hexagon5un/everled/docs/DSCF9905.JPG

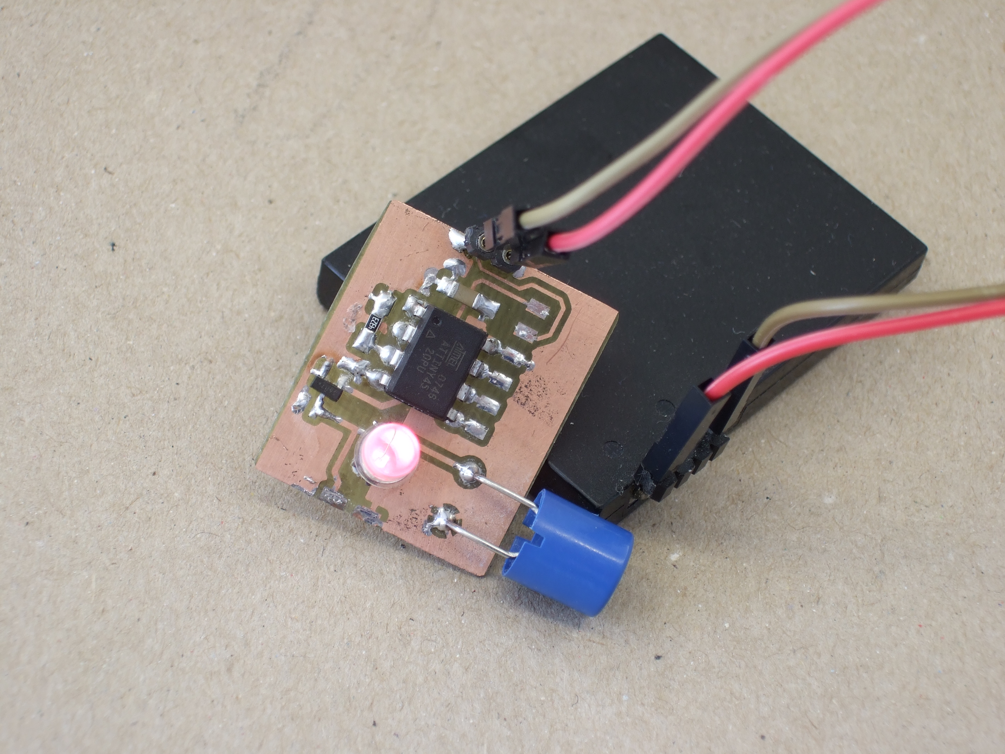
docs/DSCF9905.JPG
