hexagon5un/everled/docs/everled-F.Cu.pdf

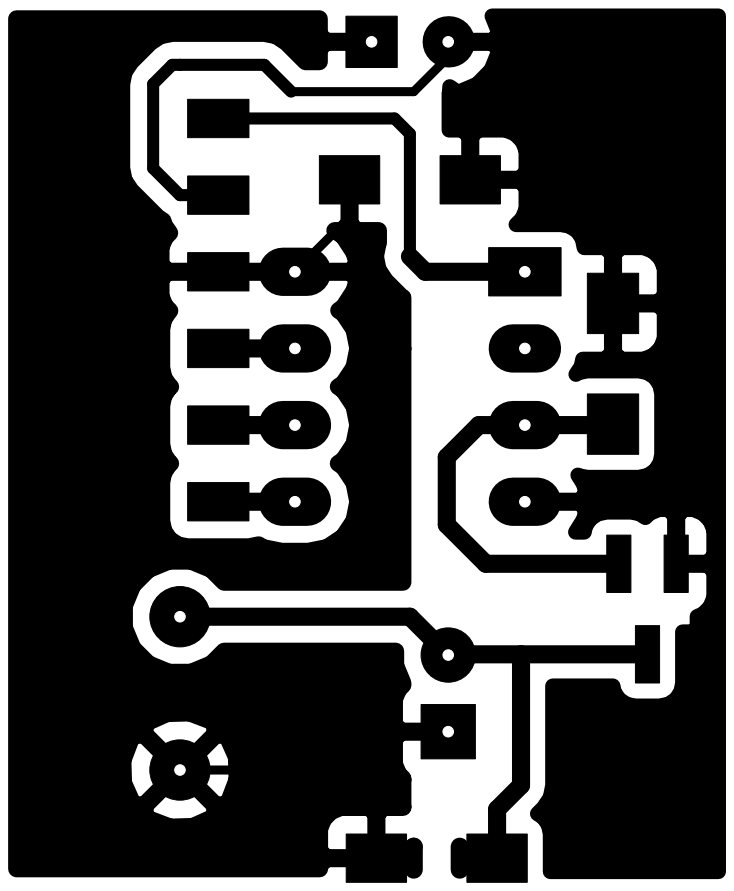
[picture p4: page 1]
