hexagon5un/everled/hardware/everled.kicad_pcb

## KiCad design hardware/everled.kicad_pcb (2017-06-26)

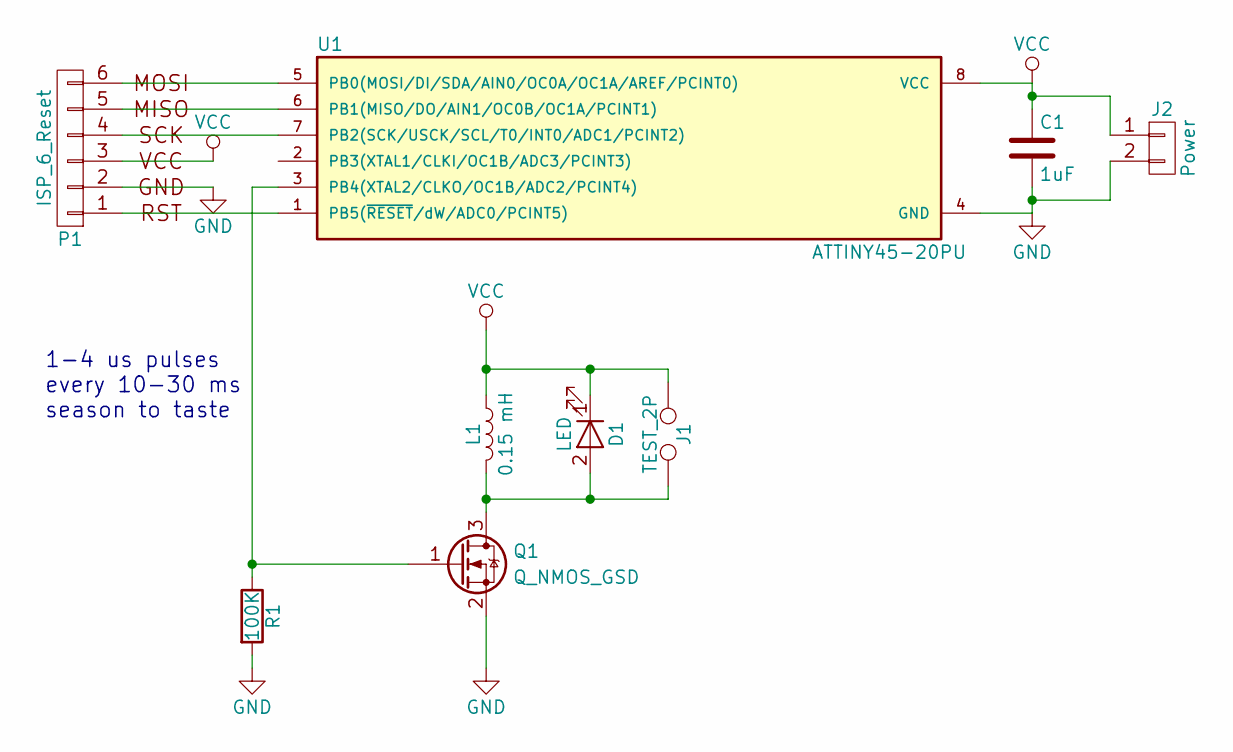
[picture p5: schematic everled.sch]

Parts:
C1: 1uF; C_1206_HandSoldering
D1: LED; LED_D5.0mm
J1: TEST_2P; R_1206_HandSoldering
J2: Power; Pin_Header_Straight_1x02_Pitch2.54mm
L1: 0.15 mH; Choke_Toroid_5x10mm_Vertical
P1: ISP_6_Reset; ISP6-Inline-Reset
Q1: Q_NMOS_GSD; SOT-23_Handsoldering
R1: 100K; R_1206_HandSoldering
U1: ATTINY45-20PU; DIP-8_W7.62mm_LongPads

Connections:
GND: C1.2, J2.2, P1.2 (RESET), Q1.2 (S), R1.2, U1.4 (GND)
unnamed: D1.2 (A), J1.2, L1.2, Q1.3 (D)
unnamed: P1.1 (GND), U1.1 (PB5(~RESET~/dW/ADC0/PCINT5))
unnamed: P1.4 (SCK), U1.7 (PB2(SCK/USCK/SCL/T0/INT0/ADC1/PCINT2))
unnamed: P1.5 (MISO), U1.6 (PB1(MISO/DO/AIN1/OC0B/OC1A/PCINT1))
unnamed: P1.6 (MOSI), U1.5 (PB0(MOSI/DI/SDA/AIN0/OC0A/OC1A/AREF/PCI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)
unnamed: Q1.1 (G), R1.1, U1.3 (PB4(XTAL2/CLKO/OC1B/ADC2/PCINT4))
VCC: C1.1, D1.1 (K), J1.1, J2.1, L1.1, P1.3 (VCC), U1.8 (VCC)

Notes on the sheet:
1-4 us pulses every 10-30 ms season to taste

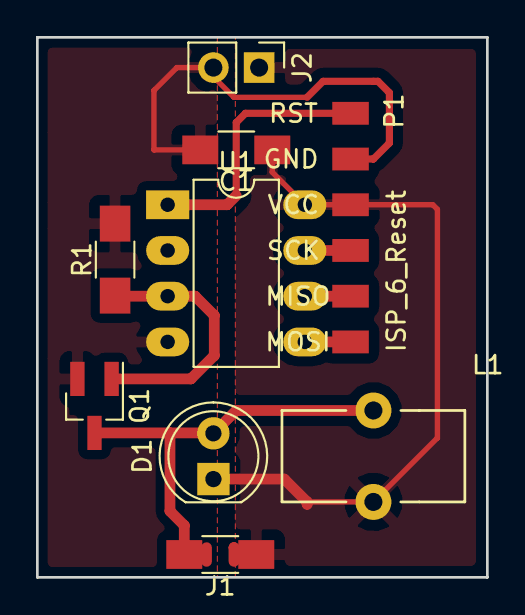
[picture p6: board everled.kicad_pcb from above]

Board: 2 copper layers, 25.0 x 30.0 mm, 9 parts (0 on the bottom side), 8 nets.
