hexagon5un/everled/(commit log)

2017-06-26 Initial commit, but tested and working
    [everled.kicad_pcb, everled.sch]
2017-06-26 moving kicad project into hardware directory
    [everled.kicad_pcb, everled.sch]
2017-06-26 added clock divisor in code, rather than in fuses
    also some notes about running at 8x apparent speed w.r.to delay.h
